eSpark-Backup/jakekrum-catanboard/Deliverables/Master PCB/_Renderings/2D_C_View.PNG

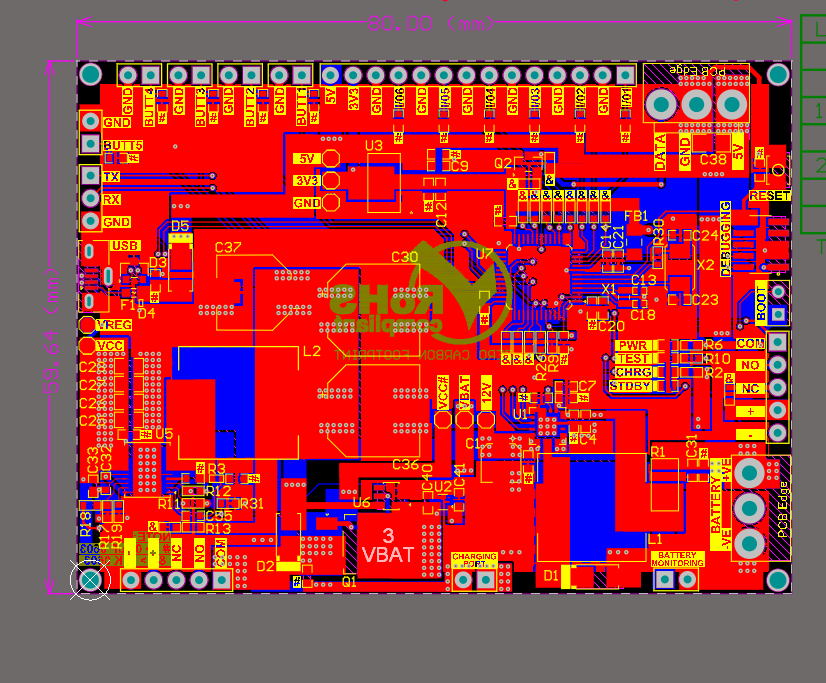
Deliverables/Master PCB/_Renderings/2D_C_View.PNG
