eSpark-Backup/jakekrum-catanboard/Deliverables/Master PCB/_Renderings/2D_Bottom_View.PNG

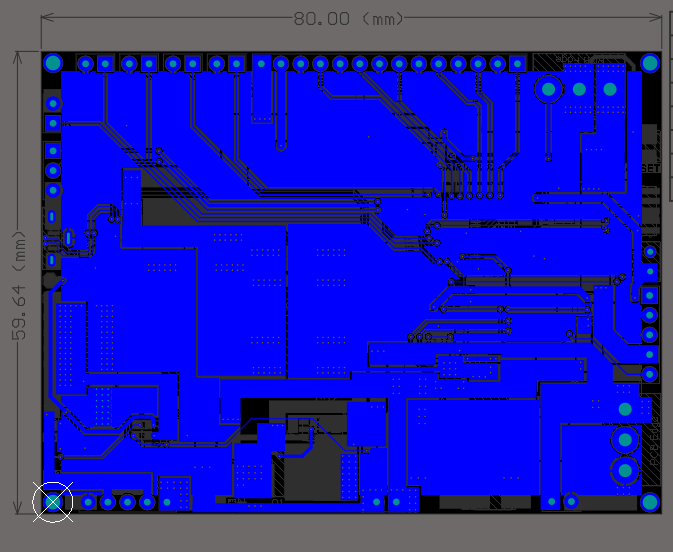
Deliverables/Master PCB/_Renderings/2D_Bottom_View.PNG
