eSpark-Backup/jakekrum-catanboard/Deliverables/Master PCB/_Renderings/3D_Bottom_View.PNG

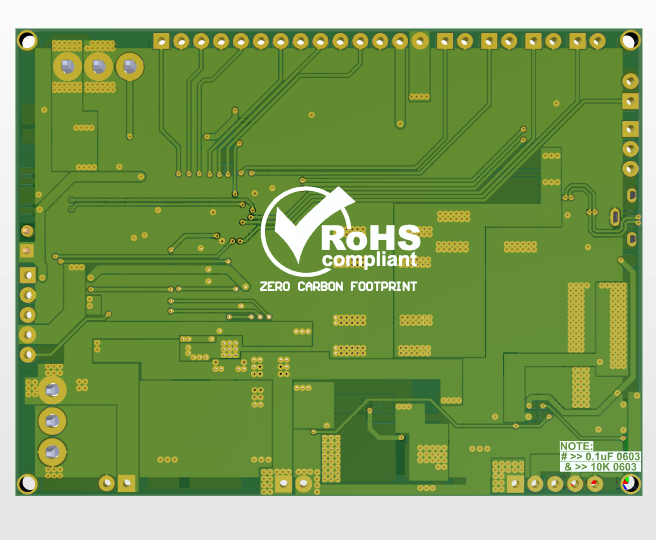
Deliverables/Master PCB/_Renderings/3D_Bottom_View.PNG
