eSpark-Backup/jakekrum-catanboard/Deliverables/Master PCB/_Renderings/3D_Isometric_View.png

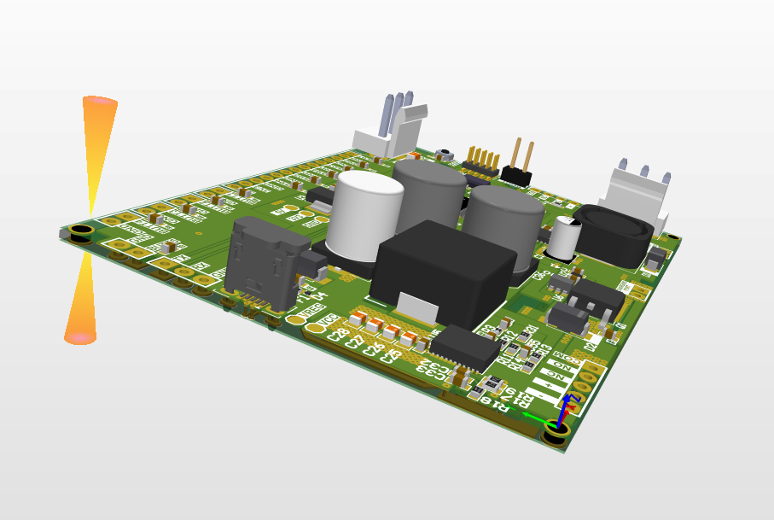
Deliverables/Master PCB/_Renderings/3D_Isometric_View.png
