eSpark-Backup/jakekrum-catanboard/Deliverables/Secondary PCB/_Renderings/2D_Bottom_View.PNG

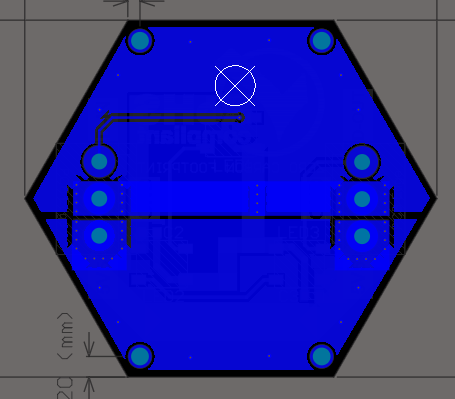
Deliverables/Secondary PCB/_Renderings/2D_Bottom_View.PNG
