eSpark-Backup/jakekrum-catanboard/Deliverables/Secondary PCB/_Renderings/2D_C_View.PNG

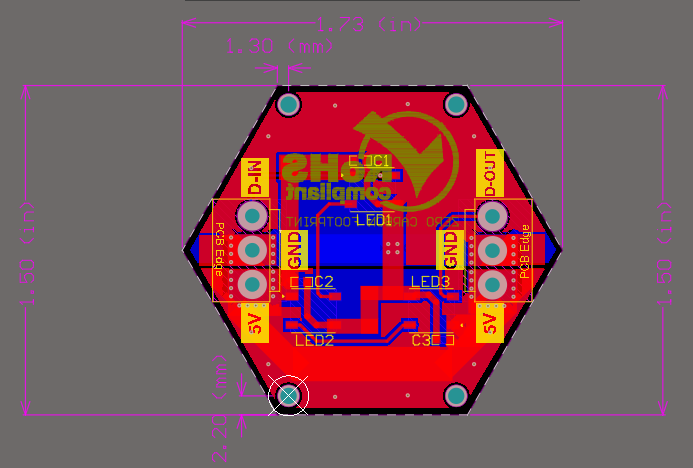
Deliverables/Secondary PCB/_Renderings/2D_C_View.PNG
