eSpark-Backup/jakekrum-catanboard/Deliverables/Secondary PCB/_Renderings/3D_Isometric_View.png

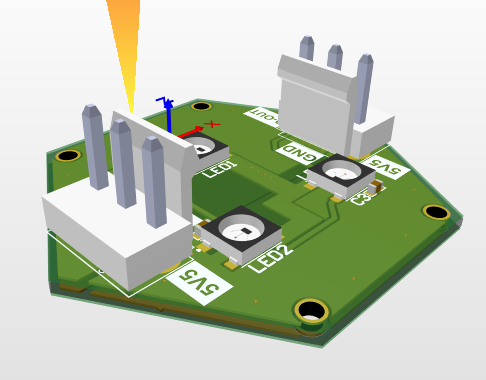
Deliverables/Secondary PCB/_Renderings/3D_Isometric_View.png
