eSpark-Backup/jakekrum-catanboard/Deliverables/Secondary PCB/_Renderings/3D_Top_View.PNG

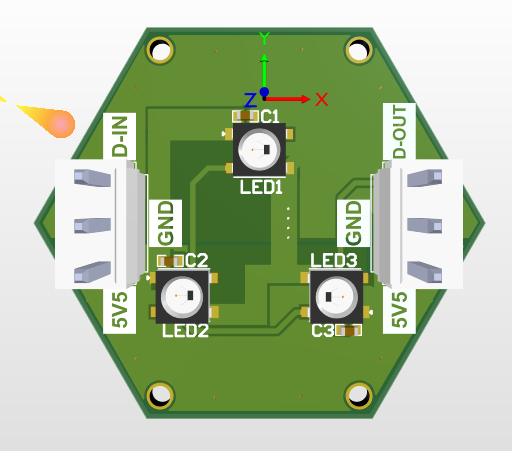
Deliverables/Secondary PCB/_Renderings/3D_Top_View.PNG
