eSpark-Backup/jakekrum-catanboard/Design Files/Catan-Board-v1.1/Master-PCB-v1.1/BOM/Master_PCB_JLCPCB_BOM_v1.1.xlsx

Comment | Designator | Footprint | LCSC Part Number
10uF | C1 | RVT1E100M0405_ | C970655
0.1uF | C2, C3, C5, C6, C8, C10, C11, C15, C16, C17, C19, C22, C29, C34, C35, C42, C43, C44, C45, C46, C47, C48, C49, C50, C51, C52, C53, C54 | Cap-0603 | C110022
10uF | C4, C7, C9 | Cap-0603 | C96446
22uF | C12 | Cap-0603 | C109447
7pF | C13, C18 | Cap-0402 | C161333
10nF | C14 | Cap-0603 | C149602
4.7uF | C20, C31 | Cap-0603 | C76615
1uF | C21, C32, C33, C40 | Cap-0603 | C14664
20pF | C23, C24 | Cap-0603 | C105621
22uF | C25, C26, C27, C28 | Cap-0805 | C338080
1000uF | C30, C36 | UUD1A102MNL1GS | C445277
560uF | C37 | GVT1C561M0810 | C2980166
100uF | C38 | Cap-1206
1nF | C41, C55 | CAP-0603 | C309470
SS34 | D1, D2, D5 | SMA | C8678
ESD5302F-3/TR | D3 | Sot-23 | C239643
PESD5V0H1BSFYL | D4 | DSN0603-2 | C477989
SMD0603-050 | F1 | Fuse-0603
100MHz | FB1 | IND-1206 | C85841
105133-0011 | J4 | 1051330011 | C586226
20021121-00010C4LF | J11 | 20021121-00010C4LF_ | C150517
B3P-VH(LF)(SN) | J12, J13 | B3P-VH(LF)(SN) | C160316
22284020 | J22 | HDR1X2_ | C234182
22UH | L1 | YPRH1204-220M_ | C338845
2.2uH | L2 | BCIH1367-2R2M | C237973
Emerald | LED1 | LED-0603 | C87326
RED | LED2, LED3, LED4 | LED-0603 | C3151730
20P03-HXY | Q1 | 20P03-HXY | C4748750
BSS138 | Q2 | Sot-23 | C426569
0.05R | R1 | RES-2010 | C844689
1K | R2, R6, R10 | Res-0603 | C165964
1.54k | R3 | Res-0402 | C396136
10K | R5, R7, R8, R14, R15, R16, R20, R21, R22, R23, R24, R25, R27, R28, R29 | Res-0603 | C95204
33K | R9 | Res-0603 | C705768
100K | R11, R12 | Res-0603 | C100048
73.2K | R13 | Res-0603 | C861548
475k | R17 | Res-0603 | C137717
147K | R19 | Res-0603 | C728612
200R | R26 | Res-0603 | C700498
390R | R30 | Res-0603 | C137632
50K | R31 | Res-0603 | C2073717
B3U-1000P | SW1 | B3U-1000P | C231329
TP5100 | U1 | TQFN-16-EP(4x4)_ | C379389
BD4860FVE-TR | U2 | VSOF-5 | C509824
AZ1117CH-3.3TRG1 | U3 | SOT- 223 | C92102
TPS53319DQPR | U5 | 22-LSON-CLIP (6x5) | C181971
LTC4412IS6#TRPBF | U6 | SOT-23-6 | C521306
STM32F070CBT6TR | U7 | 48-LQFP (7x7)_ | C2053863
32.768kHz | X1 | SMD2012-2P | C99009
8MHz | X2 | SMD5032-2P | C115962
