eSpark-Backup/jakekrum-catanboard/Design Files/Catan-Board-v1.1/Secondary-PCB-v1.0/BOM/Secondary_JLCPCB_BOM_v1.0.xlsx

Comment | Designator | Footprint | LCSC Part Number
0.1uF | C1, C2, C3 | Cap-0603 | C110022
B3P-VH(LF)(SN) | J1, J2 | B3P-VH(LF)(SN) | C160316
WS2812B-B/W | LED1, LED2, LED3 | WS2812B-B/T | C2761795
