eSpark-Backup/jakekrum-catanboard/Deliverables/Secondary PCB/_Supporting Files/Secondary_PCB.step

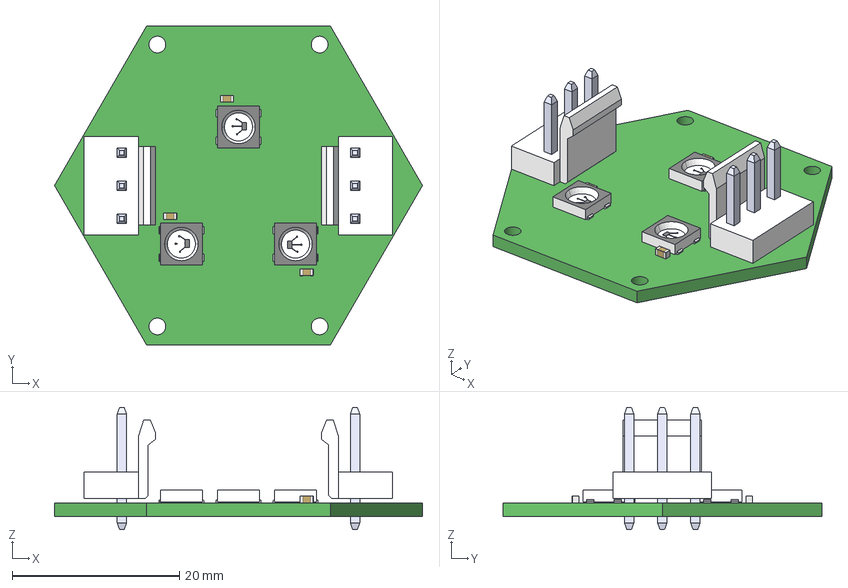
[picture p13: CAD file, 2023-07-24]
Deliverables/Secondary PCB/_Supporting Files/Secondary_PCB.step
44.0 x 38.1 x 14.6 mm
WS2812B-BW x 3
B3P-VH(LF)(SN)--3DModel-STEP-1 x 2
User_Library-CAPC1608X09 x 3
