eSpark-Backup/jakekrum-catanboard/Deliverables/Master PCB/_Supporting Files/Catan_board.step

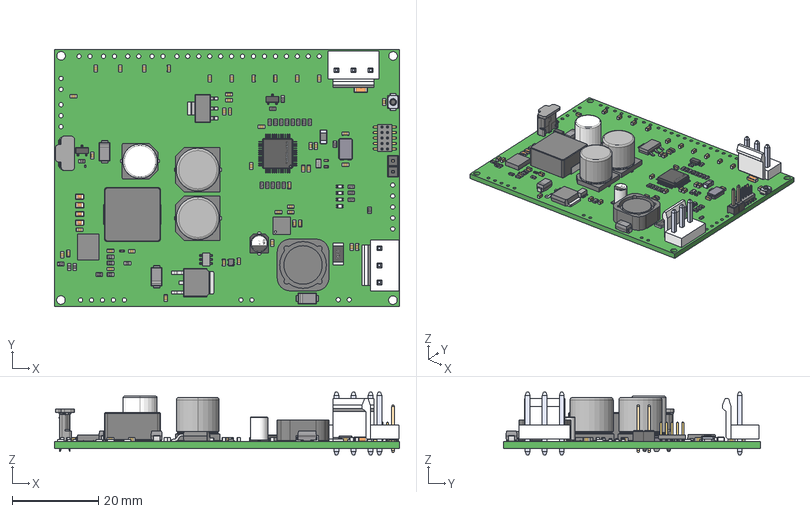
[picture p14: CAD file, 2023-07-24]
Deliverables/Master PCB/_Supporting Files/Catan_board.step
80.0 x 59.6 x 14.6 mm
User_Library-RESC1608X05N x 29
User_Library-DPAK-1
CVT1C561M0810_(1)
User_Library-RES_1005-0402
User_Library-1206_SMD_Capacitor
UUD1A102MNL1GS x 2
User_Library-LED_SMD0603 x 4
User_Library-SOT-223-1
BCIH1367-2R2M
User_Library-P-LQFP48-7x7-0_50
User_Library-32_768KHZ
21-0058I_MXM
TPS53319DQPR
Open_CASCADE_STEP_translator_6.8_10.1
Open_CASCADE_STEP_translator_6.8_10.2.1
lead x 5
TL5100--3DModel-STEP-269445
User_Library-OMRON_B3U1000P
User_Library-R_2010
CircuitWorks-SOT-23 x 2
YPRH1204-220M
User_Library-Header1x2_Header1_1 x 2
B3P-VH(LF)(SN)--3DModel-STEP-1 x 2
User_Library-RM127_10pin_Header
BLM31PG121SN1L
User_Library-DO-214AC_SMA x 3
PESD5V0H1BSF
User_Library-CAPC1608X09 x 43
User_Library-0805_SMD_Capacitor x 4
User_Library-Capacitor_0402 x 2
User_Library-4x5_4
