eSpark-Backup/jakekrum-catanboard/(list of files, cad)

Other CAD files:
Deliverables/Master PCB/_Supporting Files/Catan_board.DWG.DWG
Deliverables/Master PCB/_Supporting Files/Catan_board.DXF
Deliverables/Secondary PCB/_Supporting Files/Secondary_PCB.DWG
Deliverables/Secondary PCB/_Supporting Files/Secondary_PCB.DXF
