eSpark-Backup/jakekrum-catanboard/Design Files/Catan-Board-v1.1/Master-PCB-v1.1/Master.pdf

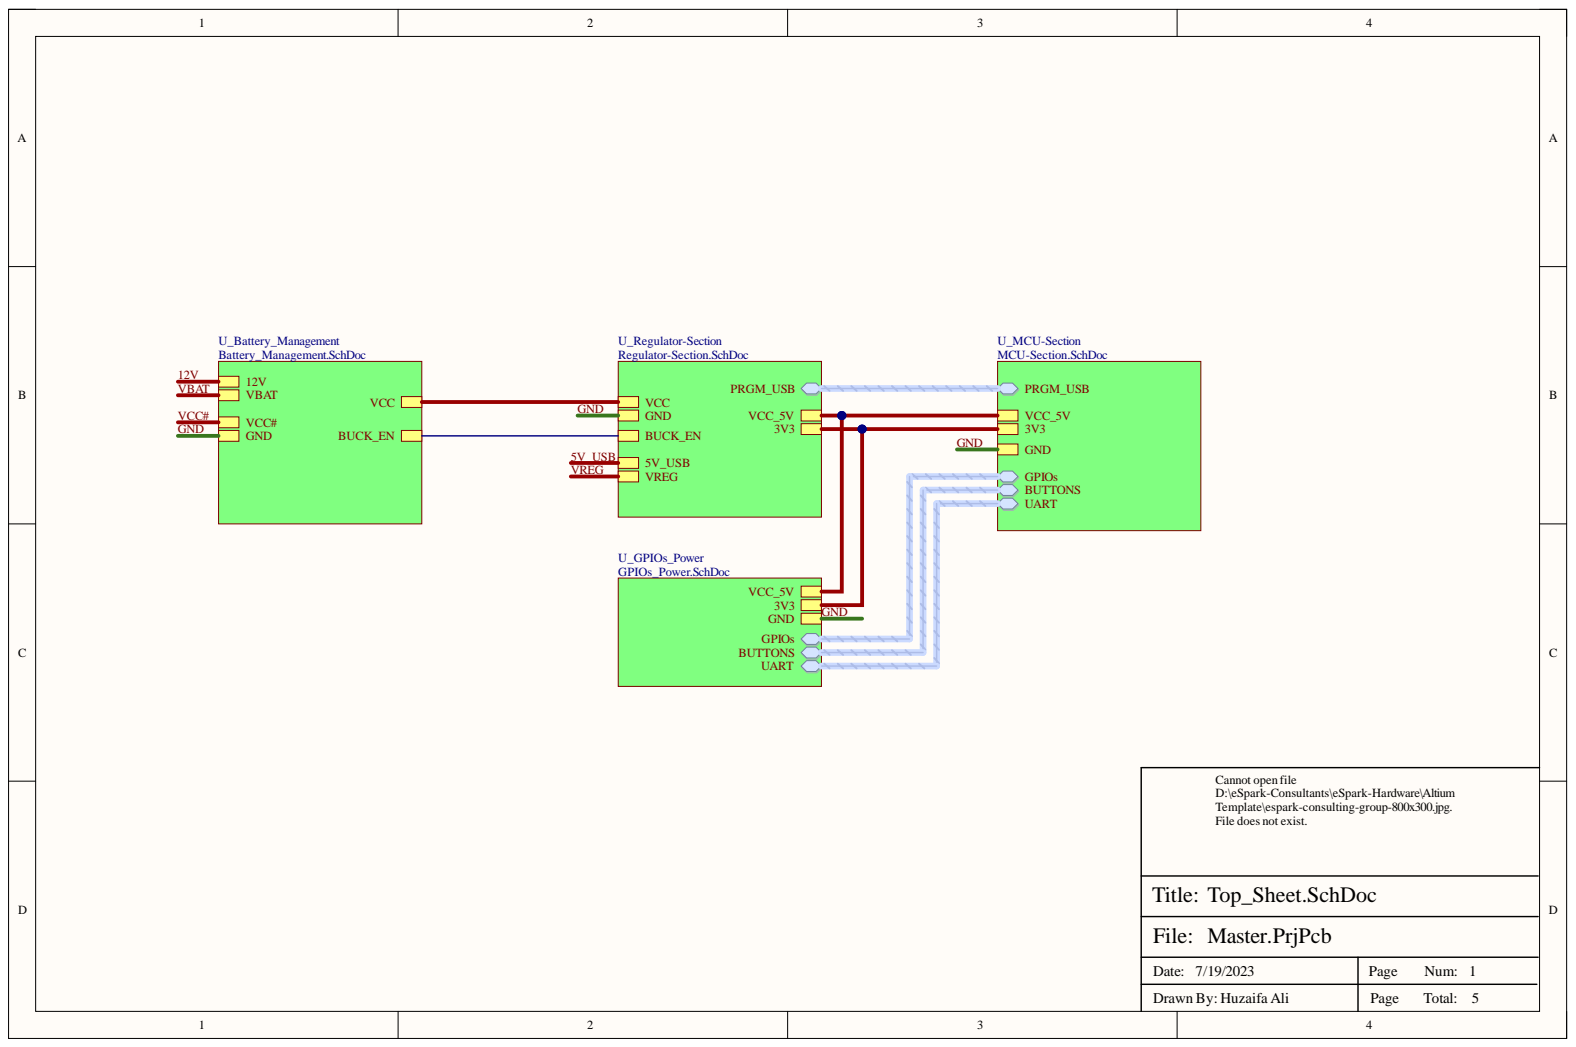
[picture p20: page 1]

Dat e : 7 / 1 9 / 2 0 2 3 | Pag e N u m : 15

D raw n B y : H uzai fa A l i | Pag e To t al :

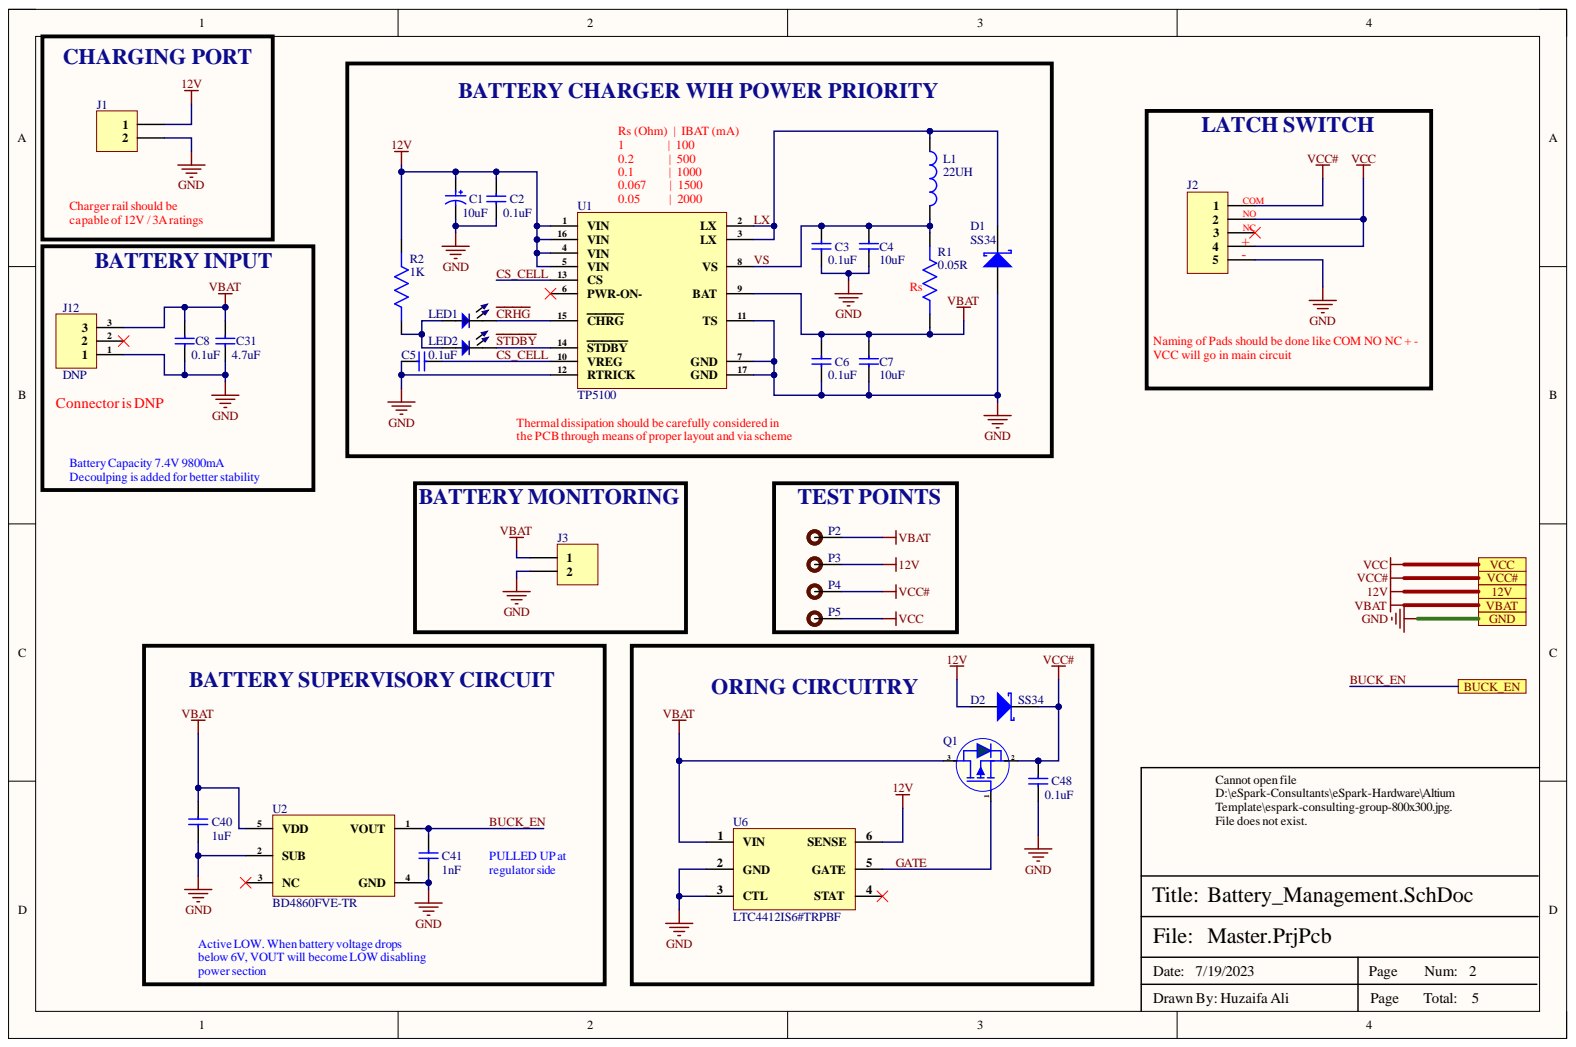
[picture p21: page 2]

Y CHARGER WIH POWER PRIORITY

ads should be done like

C will go in main

rmal dissipation should be

GATE

Dat e : 7 / 1 9 / 2 0 2 3 | Pag e N u m :

D raw n B y : H uzai fa A l i | Pag e To t al :

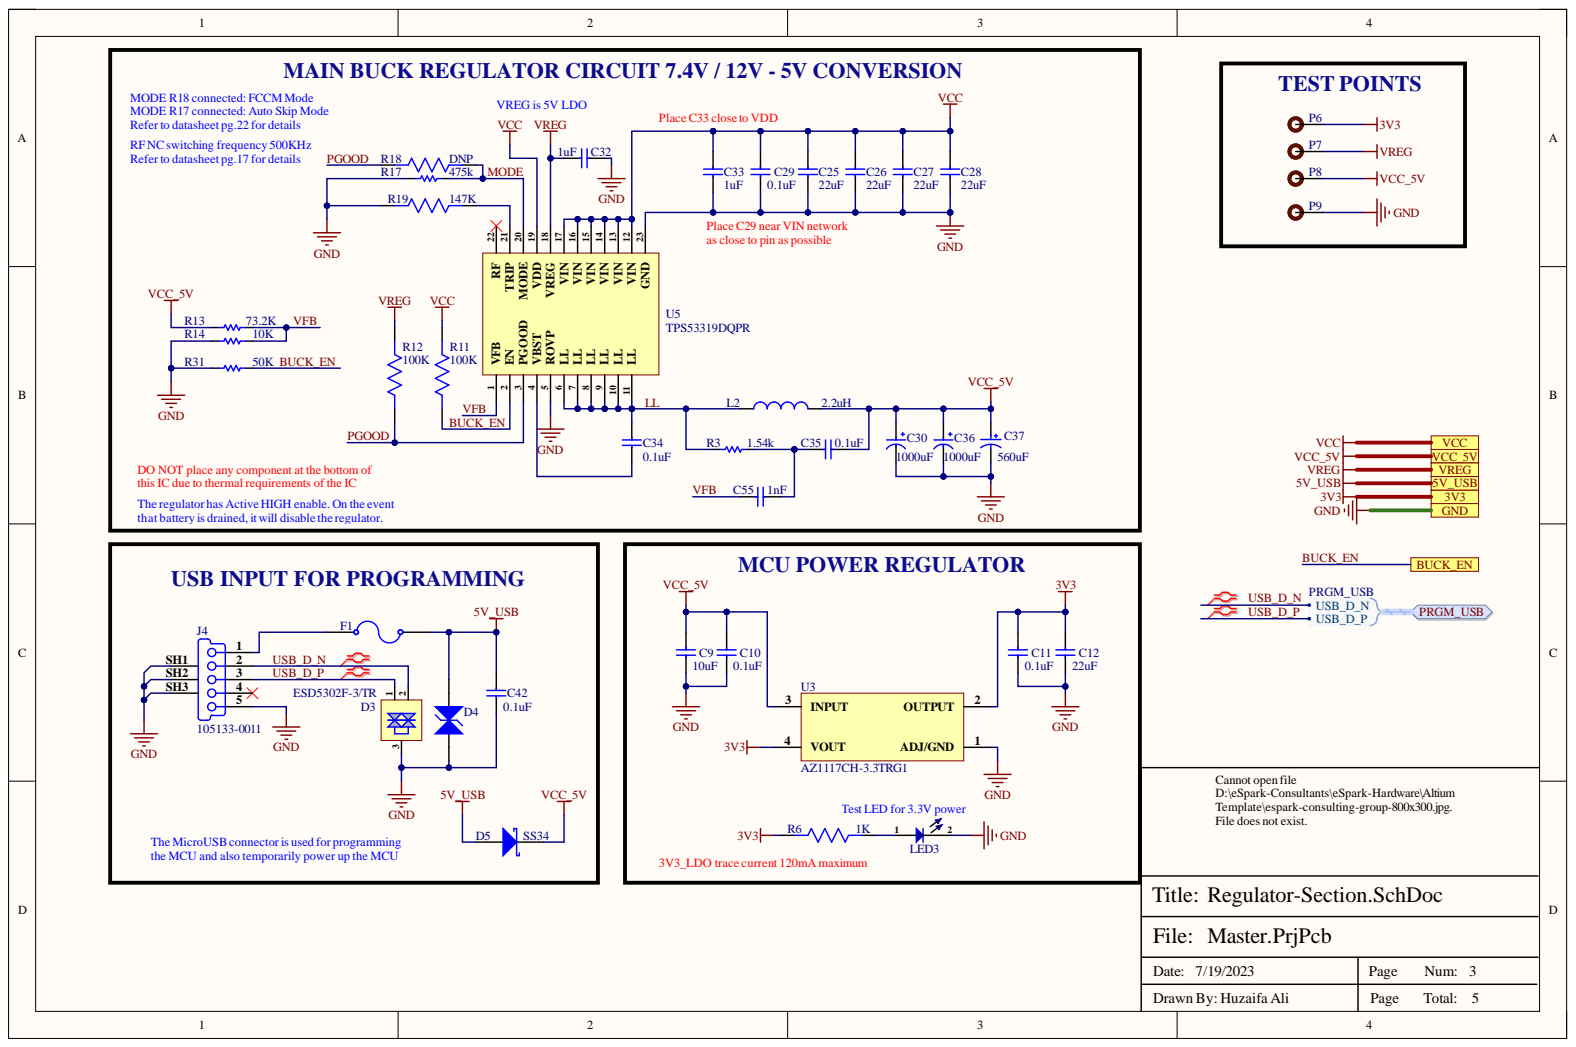
[picture p22: page 3]

MAIN BUCK REGULATOR CIRCUIT 7.4V / 12V - 5V CONVERSION

MODE R18 connected: FCCM Mode
MODE R17 connected: Auto Skip Mode
Refer to datasheet pg.22 for details
RFNCswitching frequency 500KHz
Refer to datasheet pg.17 for details

Place C33 close to VDD

Place C29 near VIN network
as close to pin as possible

LL 11 VIN 12 VIN 13 VIN 14 VIN 15 VIN 16 VIN 17 VREG 18 VDD 19 MODE 20 TRIP 21 RF 22

DO NOT place any component at the bottom of
this IC due to thermal requirements of the IC
The regulator has Active HIGH enable. On the event
that battery is drained, it will disable the regulator.

USB INPUT FOR PROGRAMMING

Cannot open file
D:\eSpark-Consultants\eSpark-Hardware\Altium
Template\espark-consulting-group-800x300.jpg.
File does not exist.

Test LED for 3.3V power

The MicroUSBconnectoris used for programming
the MCU and also temporarily power up the MCU

Date: 7/19/2023 | Page Num: 3

Drawn By: Huzaifa Ali | Page Total: 5

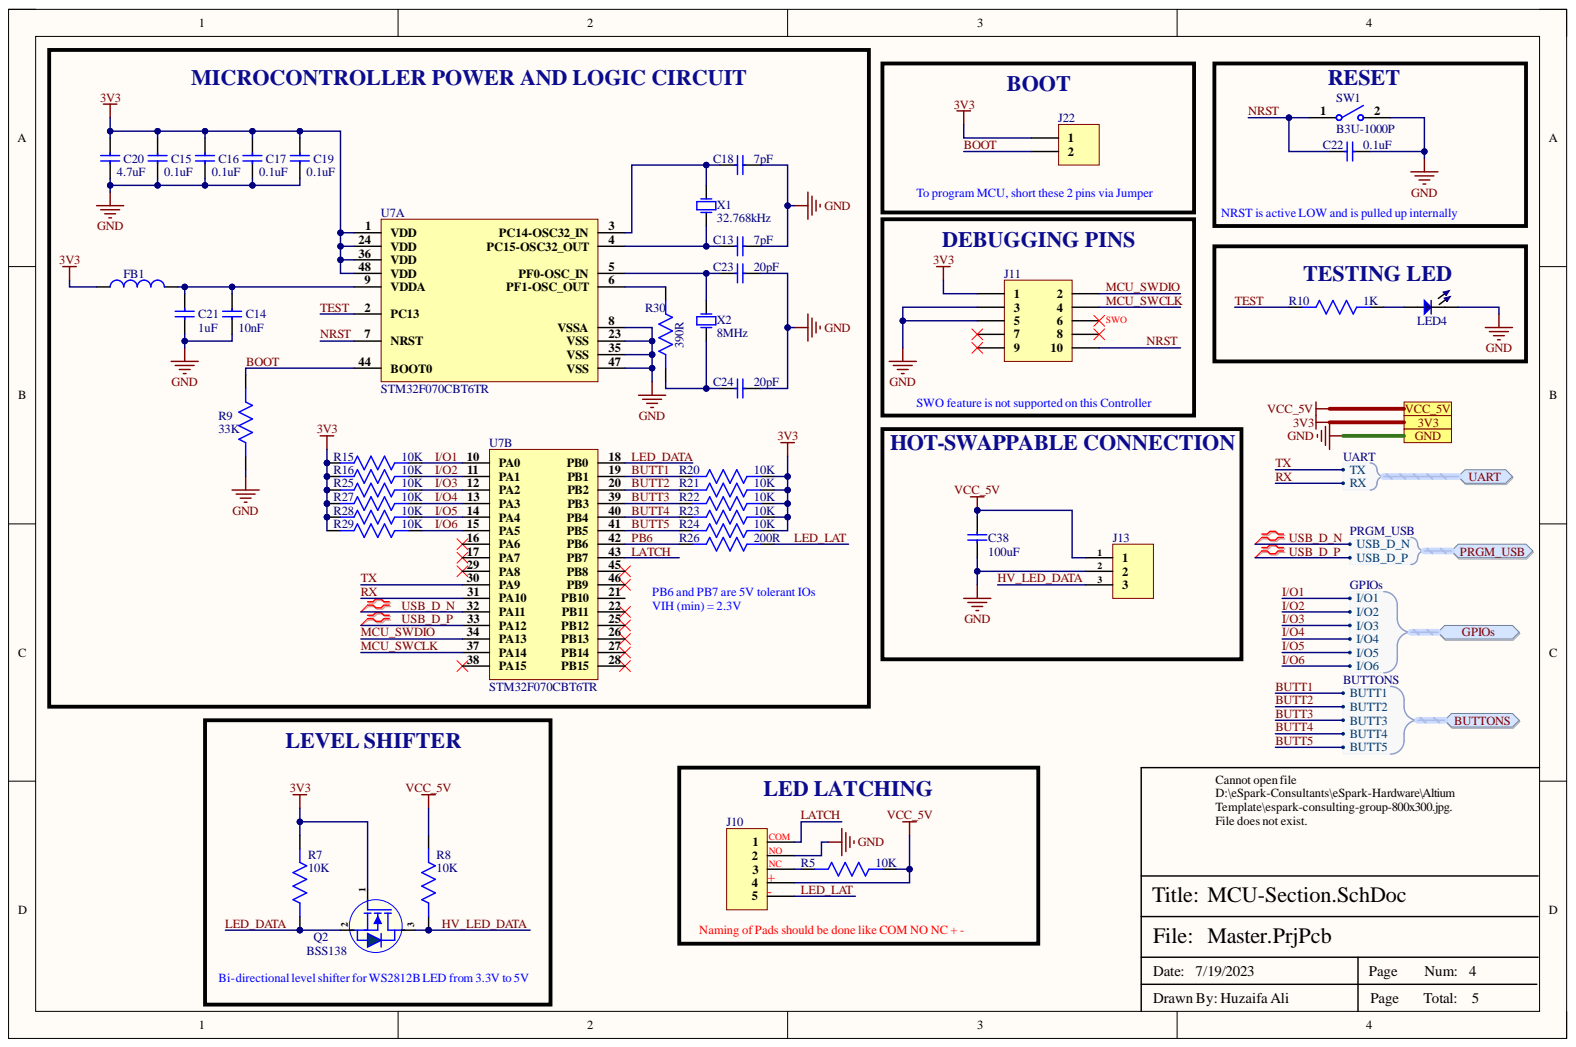
[picture p23: page 4]

MICROCONTROLLER POWER AND LOGIC CIRCUIT

To program MCU, short these 2 pins via Jumper

NRST is active LOW and is pulled up internally

GND
SWO feature is not supported on this Controller
HOT-SWAPPABLE CONNECTION

PB6 and PB7 are 5V tolerant IOs
VIH (min) = 2.3V

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

Naming of Pads should be done like COM NO NC + -

Bi-directional level shifter for WS2812BLED from 3.3V to 5V

Date: 7/19/2023 | Page Num: 4

Drawn By: Huzaifa Ali | Page Total: 5

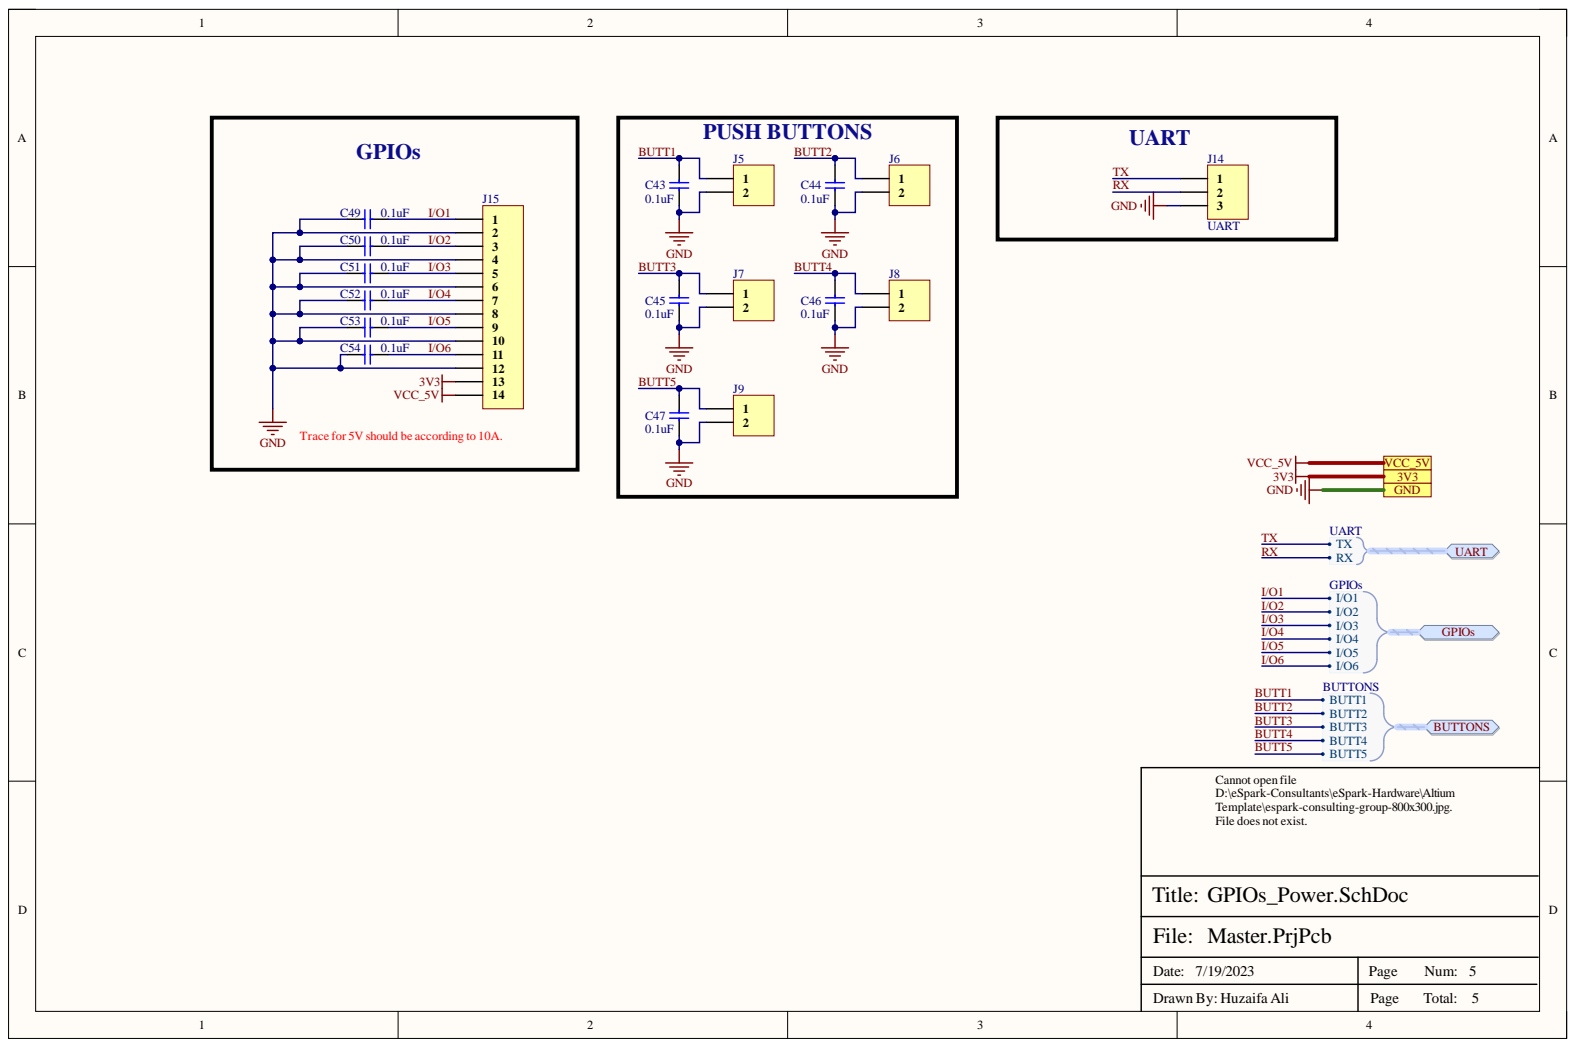
[picture p24: page 5]

Dat e : 7 / 1 9 / 2 0 2 3 | Pag e N u m : 55

D raw n B y : H uzai fa A l i | Pag e To t al :

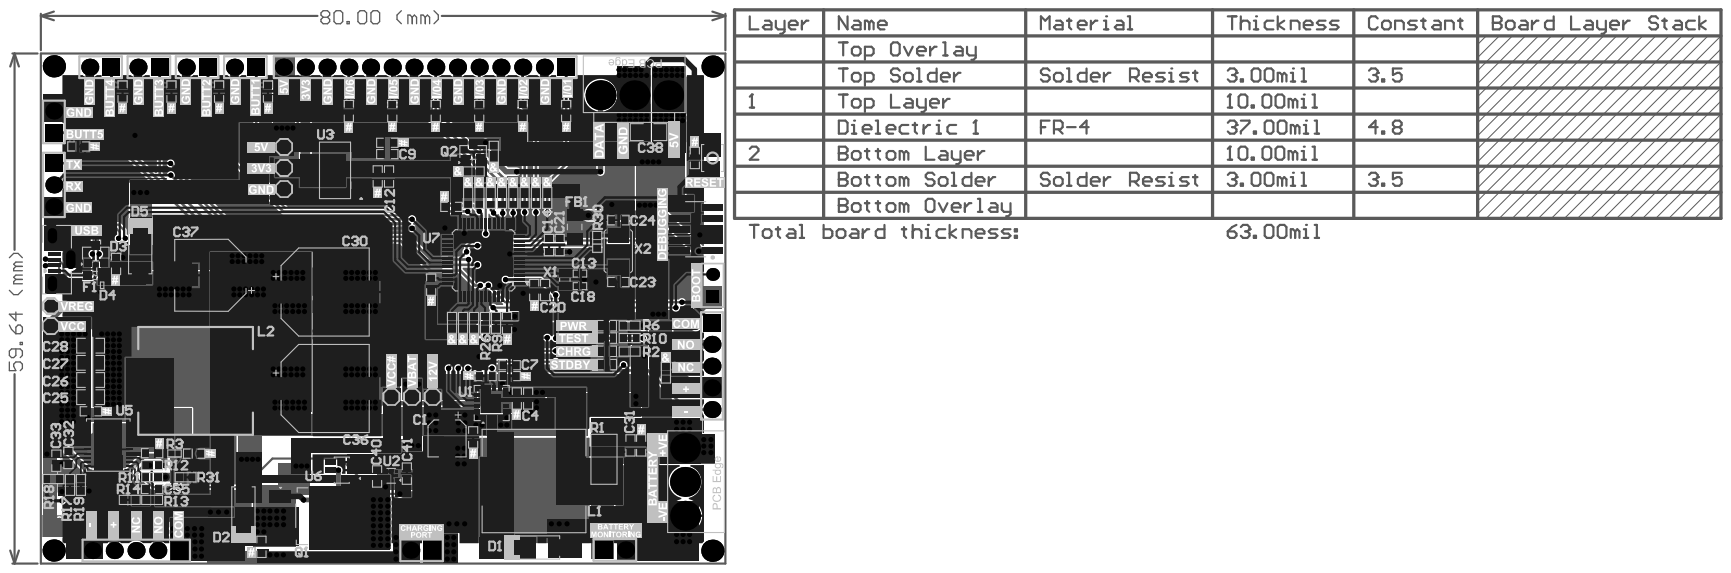
[picture p25: page 6]
