eSpark-Backup/jakekrum-catanboard/Deliverables/Master PCB/_Schematics/Assembly_Drawings.pdf

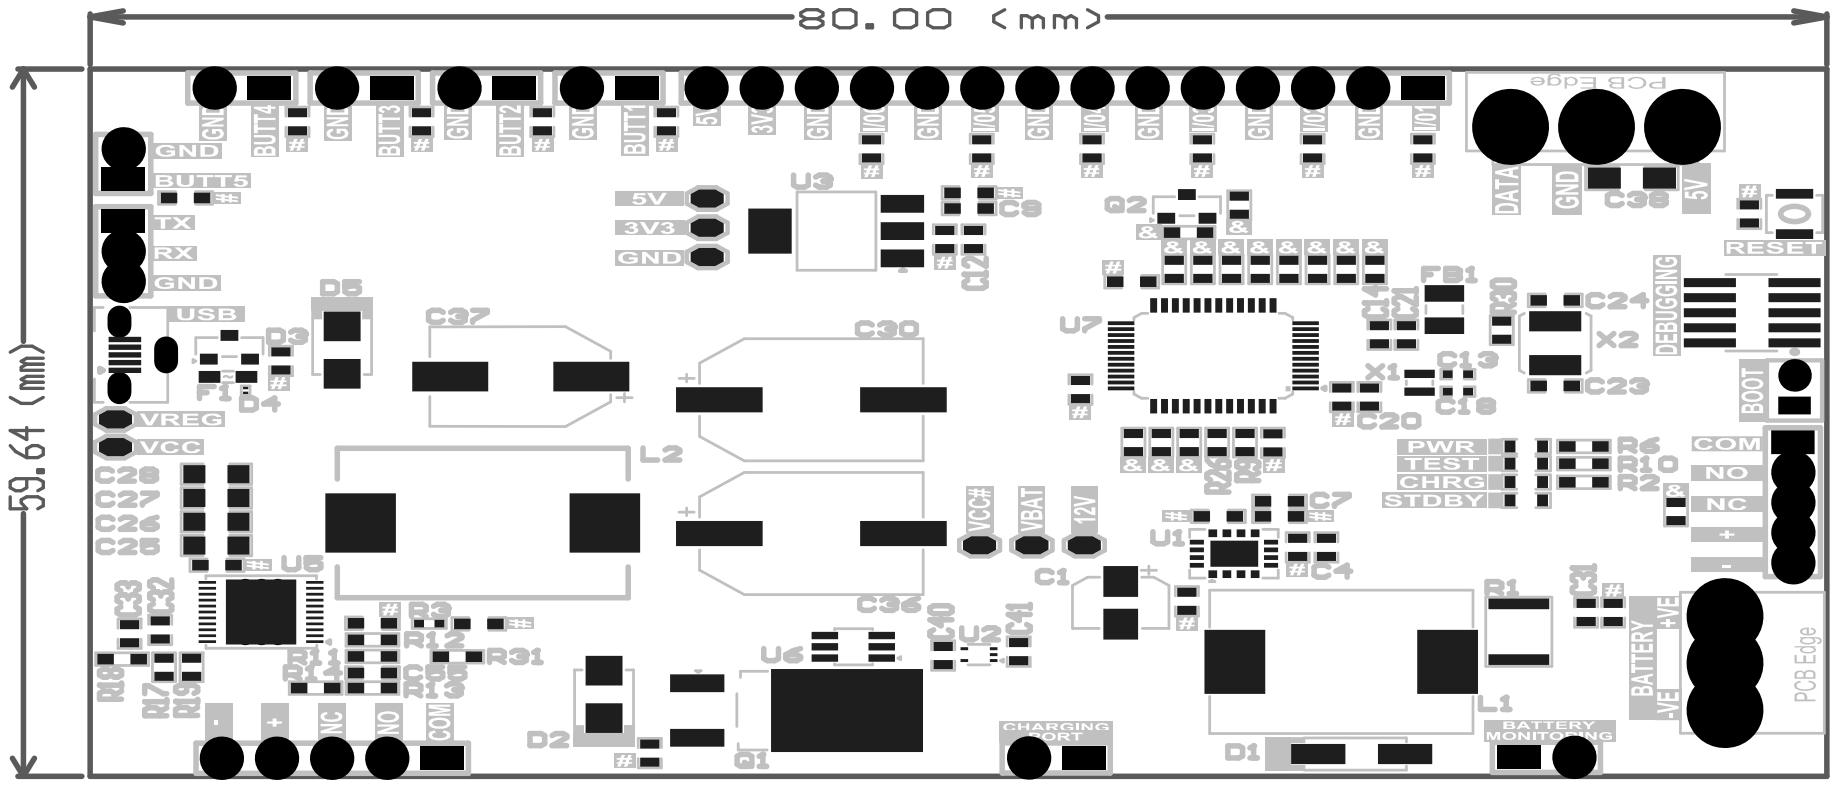
[picture p26: page 1]

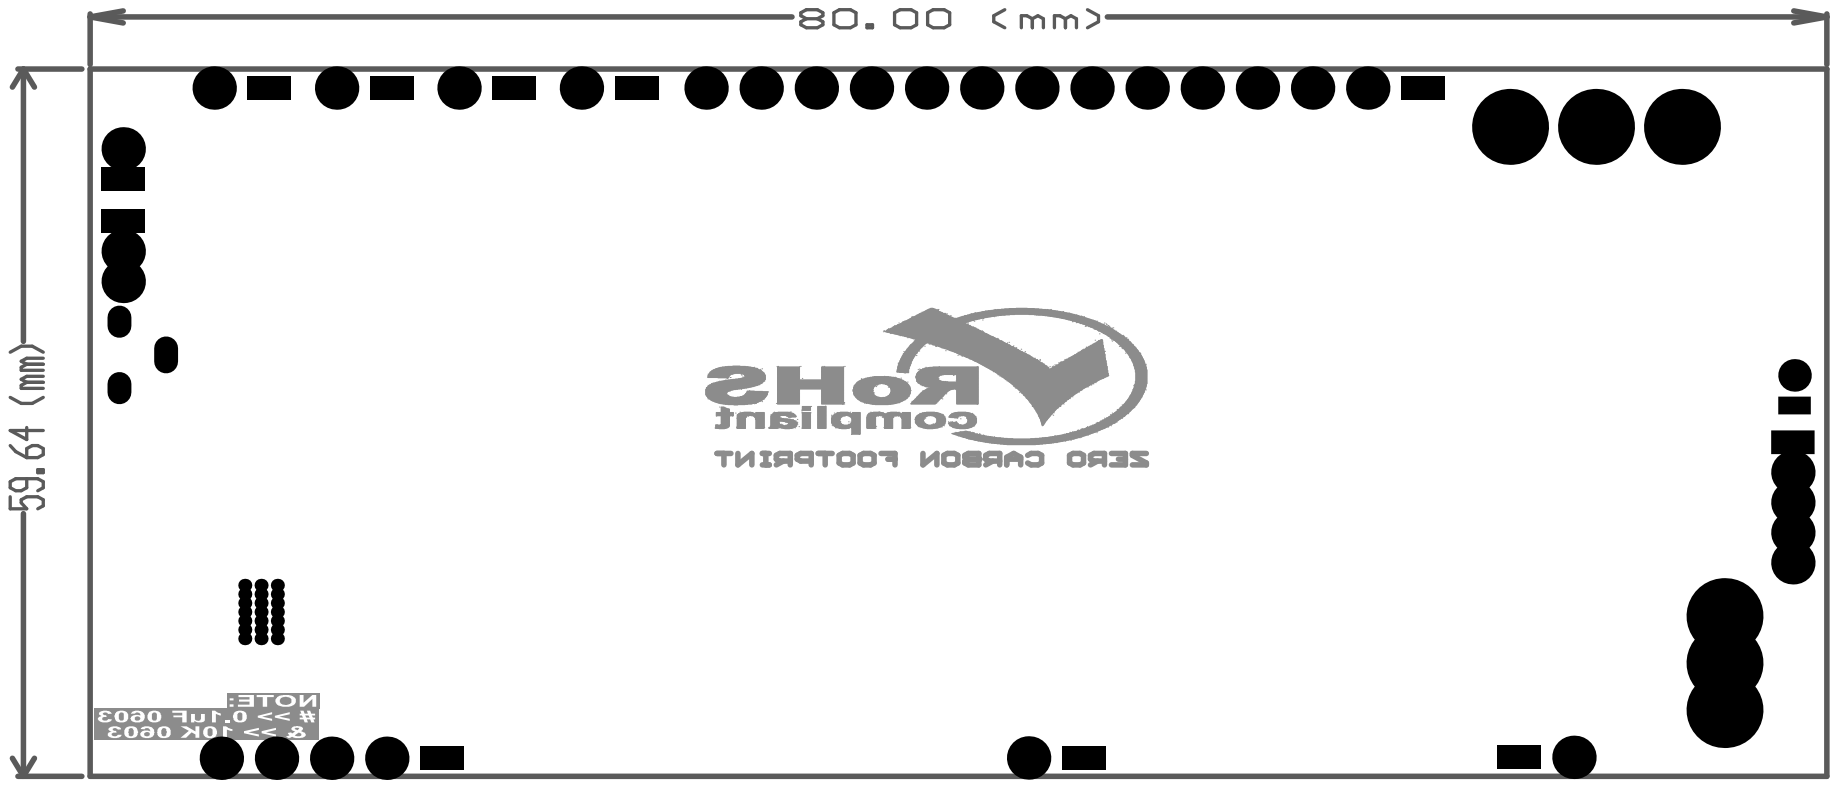
[picture p27: page 2]
