eSpark-Backup/jakekrum-catanboard/Deliverables/Secondary PCB/_Schematics/Assembly Drawings.pdf

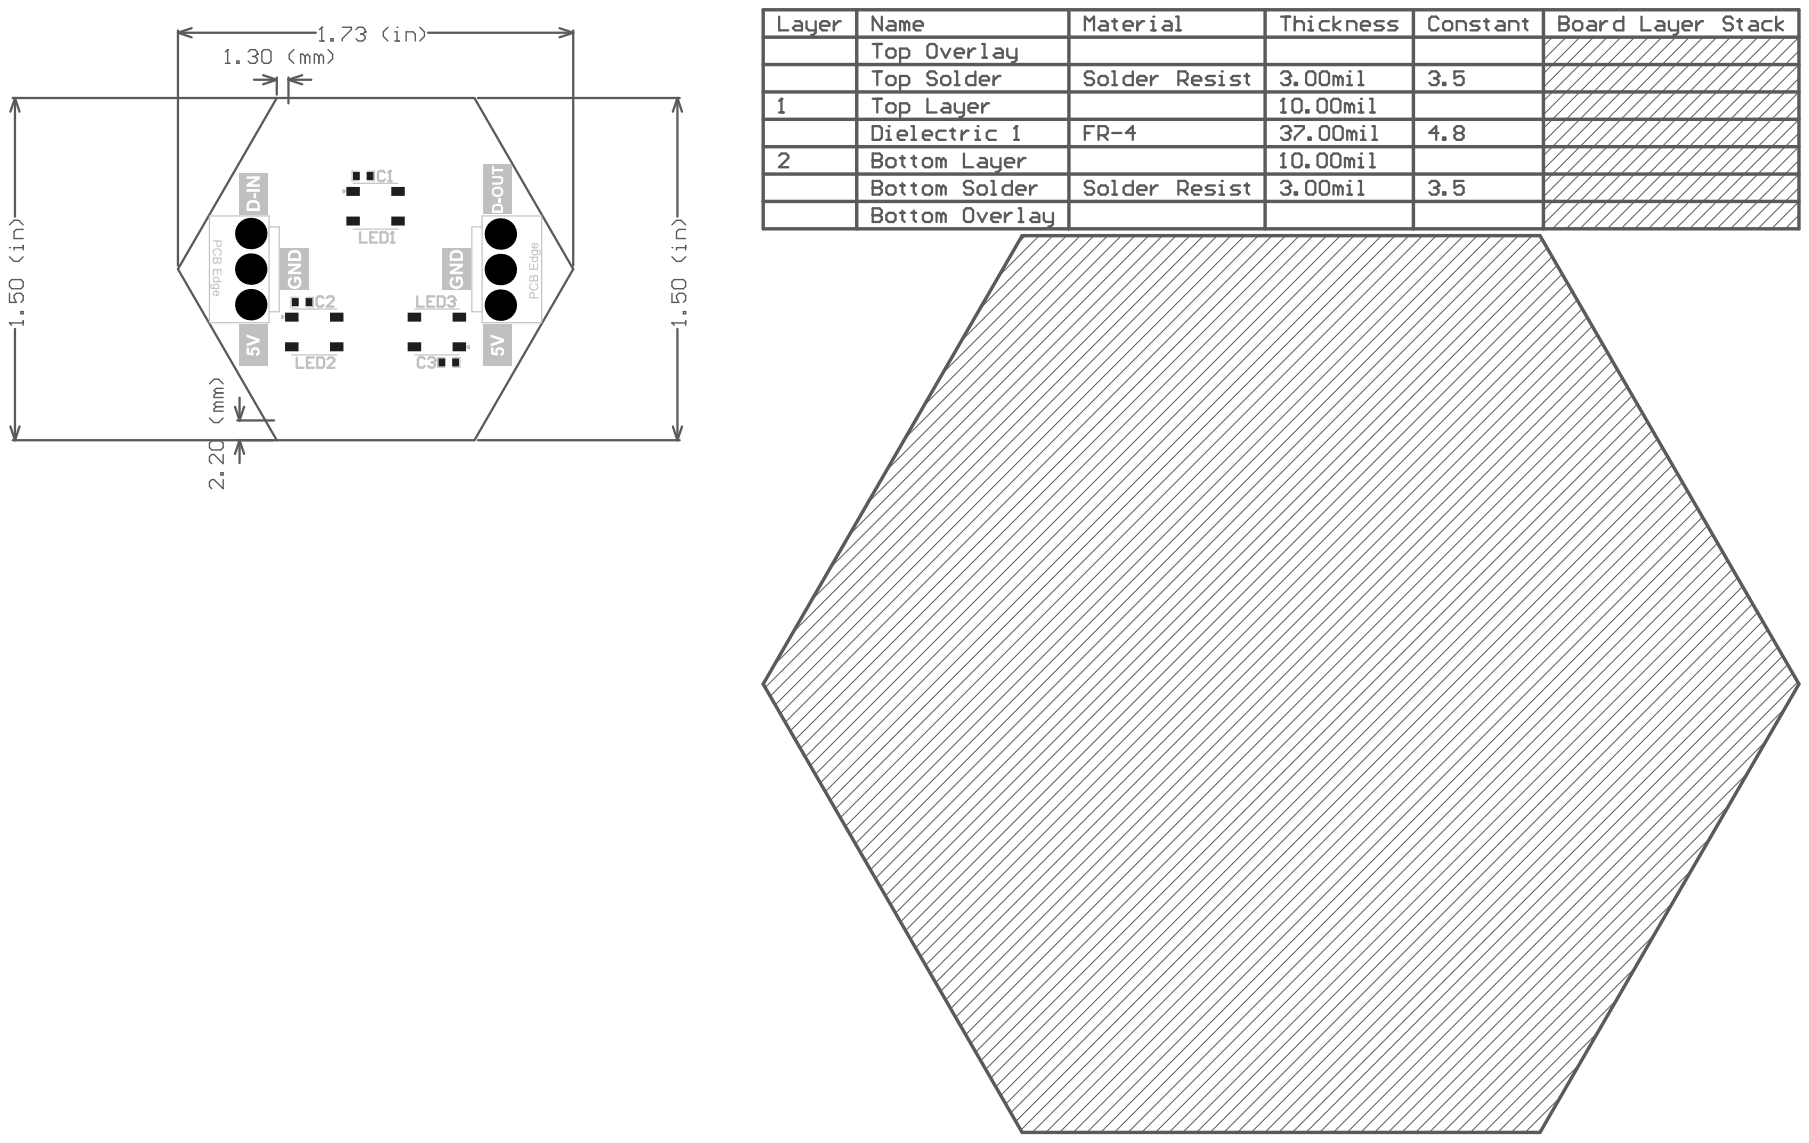
[picture p28: page 1]

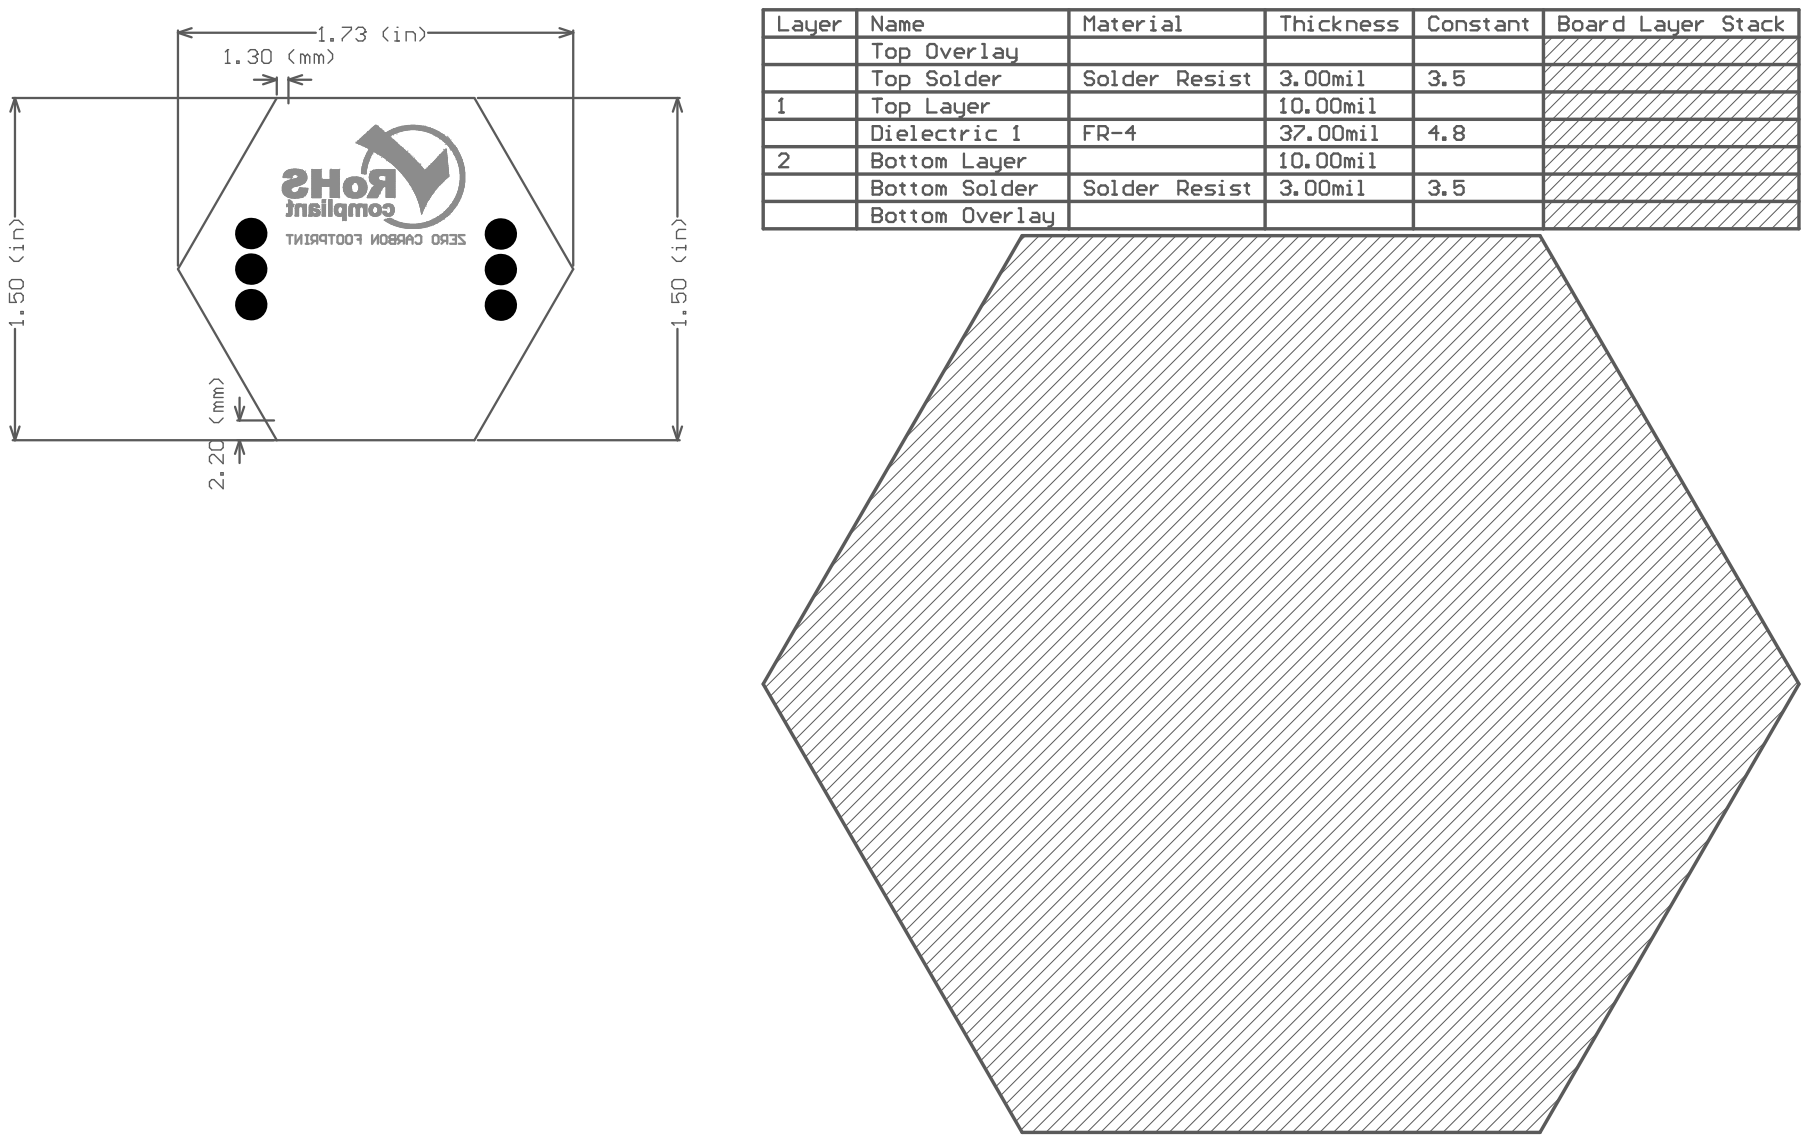
[picture p29: page 2]
