eSpark-Backup/jakekrum-catanboard/Deliverables/Secondary PCB/_Schematics/Secondary.pdf

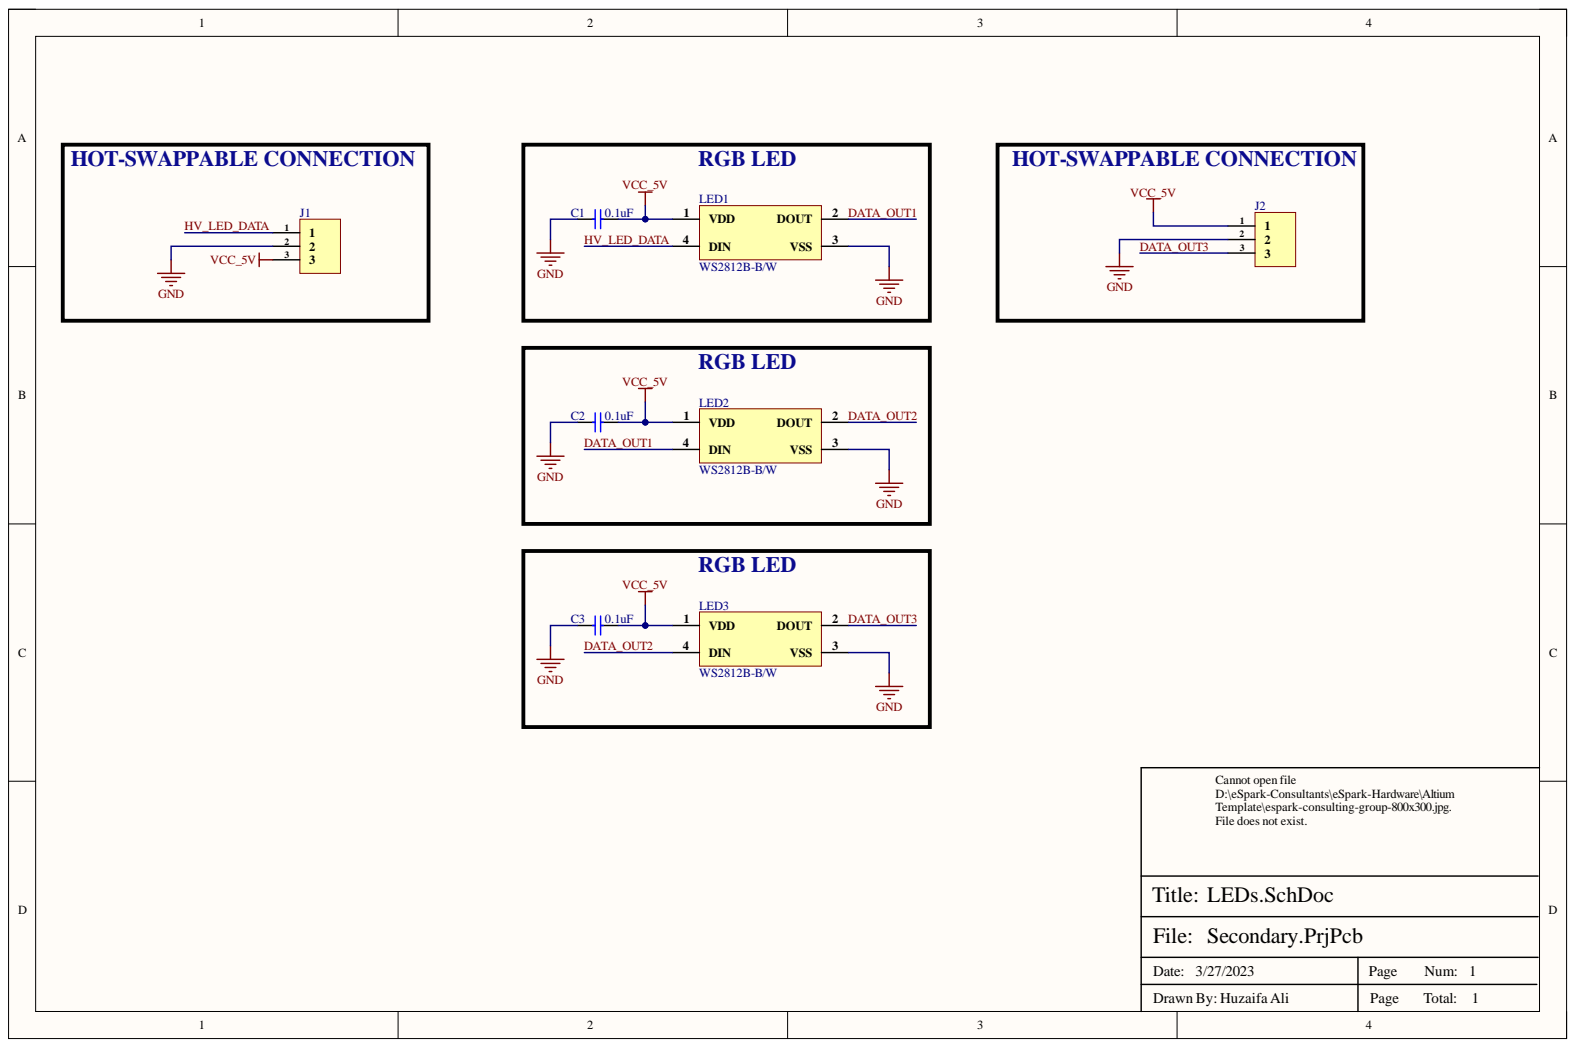
[picture p30: page 1]

DATA_OUT3 | 3 3

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

Date: 3/27/2023 | Page Num: 1

Drawn By: Huzaifa Ali | Page Total: 1
