eSpark-Backup/jakekrum-catanboard/(list of files, drawings)

Other design files:
Design Files/Catan-Board-v1.1/Master-PCB-v1.1/Battery_Management.SchDoc
Design Files/Catan-Board-v1.1/Master-PCB-v1.1/Catan-Master-v1.1.PrjPcb
Design Files/Catan-Board-v1.1/Master-PCB-v1.1/GPIOs_Power.SchDoc
Design Files/Catan-Board-v1.1/Master-PCB-v1.1/Master-PCB.PcbDoc
Design Files/Catan-Board-v1.1/Master-PCB-v1.1/MCU-Section.SchDoc
Design Files/Catan-Board-v1.1/Master-PCB-v1.1/Regulator-Section.SchDoc
Design Files/Catan-Board-v1.1/Master-PCB-v1.1/Top_Sheet.SchDoc
Design Files/Catan-Board-v1.1/Secondary-PCB-v1.0/Catan-Secondary-v1.0.PrjPcb
Design Files/Catan-Board-v1.1/Secondary-PCB-v1.0/LEDs.SchDoc
Design Files/Catan-Board-v1.1/Secondary-PCB-v1.0/Secondary-PCB.PcbDoc
