eSpark-Backup/jakekrum-catanboard/(commit log)

2023-03-02 #2 Completed
    [Hexagonal PCB.PcbDoc]
2023-03-02 #2 COmplete
    [Hexagonal PCB.PcbDoc]
2023-03-06 #2 Dimensions Updated
    [Hexagonal PCB.PcbDoc]
2023-03-07 #3 updated
    [Catan_Board.PrjPcb, Sheet1.SchDoc]
2023-03-09 #3 In progress
    [Catan_Board.PrjPcb, MCU.SchDoc, POWER.SchDoc, Sheet1.SchDoc]
2023-03-13 MCU section complete; connector section created; Buck circuit (in progress)
    [Battery_Management.SchDoc, Catan_Board.PrjPcb, Connector-Section.SchDoc, Connectors.SchDoc, Level_Shifter.SchDoc, MCU-Section.SchDoc, Regulator-Section.SchDoc]
2023-03-14 Buck regulator circuit design (complete) #3
    [Regulator-Section.SchDoc]
2023-03-14 Schematic connector changes #3 (in progress)
    [Connector-Section.SchDoc, MCU-Section.SchDoc]
2023-03-14 PRD updated with latch switch information
2023-03-14 PRD updated with latch and battery monitor configuration
2023-03-14 PRD updated with battery monitor link
2023-03-14 Push buttons added; extra components removed #3
    [Connector-Section.SchDoc, MCU-Section.SchDoc]
2023-03-15 Schematic changes in battery management #3
    [Battery_Management.SchDoc, Connector-Section.SchDoc, Level_Shifter.SchDoc, MCU-Section.SchDoc, Regulator-Section.SchDoc, Top_Sheet.SchDoc]
2023-03-15 TH addition complete; top sheet and library replacement remain #3
    [Battery_Management.SchDoc, Connector-Section.SchDoc, Level_Shifter.SchDoc, MCU-Section.SchDoc, Regulator-Section.SchDoc]
2023-03-16 Power Oring and component selection #3
    [Battery_Management.SchDoc, Connector-Section.SchDoc, Level_Shifter.SchDoc, MCU-Section.SchDoc, Regulator-Section.SchDoc]
2023-03-17 JST info added; battery connector info added in PRD
2023-03-17 Battery connector info updated
2023-03-17 #3 Design final with 3 points to replace
    [Battery_Management.SchDoc, Catan_Board.PrjPcb, Connector-Section.SchDoc, FLOW_circuit.SchDoc, Level_Shifter.SchDoc, MCU-Section.SchDoc, Regulator-Section.SchDoc, Top_Sheet.SchDoc]
2023-03-20 #3 Changes done: Connector alternate done, Inductor alternate done and Debugging pins added
    [Battery_Management.SchDoc, Catan_Board.PrjPcb, MCU-Section.SchDoc, Regulator-Section.SchDoc, Top_Sheet.SchDoc]
2023-03-20 #4 Schematic done
    [LEDs.SchDoc]
2023-03-20 #4 Folder ajdusted
    [Secondary_PCB.PrjPcb]
2023-03-20 PRD updated with additional UART and input TH pad
2023-03-20 #3 Comments added and files renamed
    [Battery_Management.SchDoc, MCU-Section.SchDoc, Master.PrjPcb, Regulator-Section.SchDoc, Secondary.PrjPcb, Top_Sheet.SchDoc]
2023-03-20 #3 TH pads added for GPIOs and UART
    [Battery_Management.SchDoc, GPIOs_Power.SchDoc, MCU-Section.SchDoc, Master.PrjPcb, Top_Sheet.SchDoc]
2023-03-21 #5 #3 All Recommended changes made
    [Battery_Management.SchDoc, LEDs.SchDoc, MCU-Section.SchDoc, Regulator-Section.SchDoc]
2023-03-21 #3 #5 Battery Connector Changed with DNP
    [Battery_Management.SchDoc]
2023-03-22 #3 Connector changed for GPIOs and placement changed for UART
    [Battery_Management.SchDoc, GPIOs_Power.SchDoc, MCU-Section.SchDoc, Regulator-Section.SchDoc, Top_Sheet.SchDoc]
2023-03-22 #4 Decoupling Capacitors added
    [LEDs.SchDoc]
2023-03-22 #3 MCU replacement from centralized library
    [Battery_Management.SchDoc, MCU-Section.SchDoc]
2023-03-22 #7 In progress
    [Hexagonal PCB.PcbDoc, Secondary.PrjPcb]
2023-03-22 #6 Placement in Progress
    [Catan_board.PcbDoc, GPIOs_Power.SchDoc, Master.PrjPcb]
2023-03-24 #3 GPIO pad replaced with Centralized Library
    [GPIOs_Power.SchDoc]
2023-03-24 #3 INPUT Header pins changed
    [LEDs.SchDoc]
2023-03-24 #6 Placement completed some designator formatting and Routing remaining
    [Battery_Management.SchDoc, Catan_board.PcbDoc, GPIOs_Power.SchDoc, MCU-Section.SchDoc, Regulator-Section.SchDoc, Top_Sheet.SchDoc]
2023-03-24 #7 Completed
    [Hexagonal PCB.PcbDoc, Secondary.PrjPcb]
2023-03-26 #8 Designators and Labels changed and fills added for 5V and GND as well.
    [Hexagonal PCB.PcbDoc, LEDs.SchDoc]
2023-03-27 removed extra PCB file
    [Hexagonal PCB.PcbDoc]
2023-03-27 #6 Routing in Progress
    [Battery_Management.SchDoc, Catan_board.PcbDoc, Master.PrjPcb, Regulator-Section.SchDoc]
2023-03-27 #8 Polygon Pour split on both Top and Bottom layer.
    [Hexagonal PCB.PcbDoc, LEDs.SchDoc, Secondary.PrjPcb, Secondary_PCB.PcbDoc]
2023-03-27 #8 Deliverables (Production and Non-Production files)generated.
    [Centroid File.csv, LEDs.SchDoc, Secondary.PrjPcb, Secondary_PCB.DWG, Secondary_PCB.DXF, Secondary_PCB.PcbDoc, Secondary_PCB.step]
2023-03-27 #8 Updated Pick n Place file generated.
    [Pick Place for Secondary_PCB.csv, Secondary.PrjPcb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]
2023-03-27 Gerber and Pick n Place folder moved to Design Files folder.
    [Centroid File.csv, Pick Place for Secondary_PCB.csv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]
2023-03-28 #3 Comment changed of C22
    [MCU-Section.SchDoc]
2023-03-28 #3 Comments of 100nf Capacitors changed to 0.1uF
    [GPIOs_Power.SchDoc]
2023-03-28 #8 Fresh Deliverables after changes in Text and Polygon pour.
    [Centroid File.csv, LEDs.SchDoc, Pick Place for Secondary_PCB.csv, Secondary.PrjPcb, Secondary_PCB.DWG, Secondary_PCB.DXF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]
2023-03-28 #6 Routing In Progress.
    [Battery_Management.SchDoc, Catan_board.PcbDoc, GPIOs_Power.SchDoc, MCU-Section.SchDoc, Master.PrjPcb, Regulator-Section.SchDoc, Top_Sheet.SchDoc]
2023-03-29 #6 Routing Completed
    [Catan_board.PcbDoc, Master.PrjPcb, Regulator-Section.SchDoc]
2023-03-29 #3 Inductor and Capacitors for buck regulator replaced
    [Master.PrjPcb, Regulator-Section.SchDoc]
2023-03-29 #10 Changes in Routing during Review and after replacement of C30, C36, C37 and L2.
    [Battery_Management.SchDoc, Catan_board.PcbDoc, GPIOs_Power.SchDoc, MCU-Section.SchDoc, Master.PrjPcb, Regulator-Section.SchDoc, Top_Sheet.SchDoc]
2023-03-30 #3 USB connector replaced with horizontal
    [Regulator-Section.SchDoc]
2023-03-30 Revert "#3 USB connector replaced with horizontal"
    This reverts commit 67cdf25e04ab7b7918c27433311ef3a76c3f0391.
    [Regulator-Section.SchDoc]
2023-03-30 #6 changes done according to review
    [Catan_board.PcbDoc, Master.PrjPcb]
2023-03-30 #10 Components replaced as mentioned
    [Battery_Management.SchDoc, GPIOs_Power.SchDoc, MCU-Section.SchDoc, Regulator-Section.SchDoc]
2023-03-30 #6 LED , Capacitor and Resistor updated in PCB
    [Catan_board.PcbDoc, GPIOs_Power.SchDoc, MCU-Section.SchDoc, Master.PrjPcb]
2023-03-30 #11 BOM and Centroid File Completed
    [Centroid for Catan_board.csv, JLCPCB BOM.xlsx]
2023-03-30 #10 In-Progress (MCU and GPIO Sheets done).
    [Battery_Management.SchDoc, Catan_board.PcbDoc, GPIOs_Power.SchDoc, MCU-Section.SchDoc, Master.PrjPcb, Regulator-Section.SchDoc, Top_Sheet.SchDoc]
2023-03-31 #10 In-Progress (Regulator Sheet remaining only).
    [Battery_Management.SchDoc, Catan_board.PcbDoc, GPIOs_Power.SchDoc, MCU-Section.SchDoc, Regulator-Section.SchDoc, Top_Sheet.SchDoc]
2023-04-01 #5 VDR added on EN pin.
    [Master.PrjPcb, Regulator-Section.SchDoc]
2023-04-01 #5 560uF, 100uF added; R3 replaced; R4 removed.
    [MCU-Section.SchDoc, Regulator-Section.SchDoc]
2023-04-02 #10 Review completed with modification in Routing for U1 and U5.
    [Battery_Management.SchDoc, Catan_board.PcbDoc, GPIOs_Power.SchDoc, MCU-Section.SchDoc, Regulator-Section.SchDoc, Top_Sheet.SchDoc]
2023-04-02 #12 Deliverables created and updated on Git.
    [Battery_Management.SchDoc, Catan_board.DWG, Catan_board.DXF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]
2023-04-02 #12 Fresh Deliverables generated.
    [Battery_Management.SchDoc, Catan_board.DWG, Catan_board.DWG.DWG, Catan_board.DXF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]
2023-04-02 #12 Gerber, NC Drill and Pick n Place newly created after adding Fabrication layer in PCB.
    [Battery_Management.SchDoc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]
2023-04-03 #11 JLCPCB BOM Updated extra Centroid File Folder Deleted
    [Centroid for Catan_board.csv, JLCPCB BOM.xlsx]
2023-04-05 capacitor C37 replaced due to JLCPCB
    [Regulator-Section.SchDoc]
2023-04-05 project saved
    [Master.PrjPcb]
2023-04-05 #12 Fresh Gerber, NC Drill and Pick n Place files generated.
    [Battery_Management.SchDoc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]
2023-04-05 C37 part number updated #13
    [JLCPCB BOM.xlsx]
2023-04-05 WS2812B led alternate added
    [JLCPCB BOM.xlsx]
2023-06-07 RGB LED transient color change
2023-07-18 #16 Changes done
    [Battery_Management.SchDoc, Master.PrjPcb, Regulator-Section.SchDoc]
2023-07-19 #16 All 10k resistors replaced
    [MCU-Section.SchDoc]
2023-07-19 #17 PCB updated acc to changes mention in #16 and all 10K resistor updated with same part no: in PCB , Deliverables also generated
    [Battery_Management.SchDoc, Catan_board.DWG.DWG, Catan_board.DXF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]
2023-07-19 #18 Master PCB BOM updated
    [JLCPCB BOM.xlsx, Master_PCB_JLCPCB_BOM.xlsx]
2023-07-19 #16 DNP comment removed
    [Battery_Management.SchDoc]
2023-07-19 J12 added in Centroid file as changes updated in schematic #16
    [Centroid_File.csv]
2023-07-24 Naming convention updated
    [Battery_Management.SchDoc, Catan-Master-v1.1.PrjPcb, Catan-Secondary-v1.0.PrjPcb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]
